Arucious/vesa-speaker-tray/(list of files, cad)

Other CAD files:
vesa_tray_generator_single.scad
