Arucious/vesa-speaker-tray/(commit log)

2026-06-12 Add parametric VESA speaker tray OpenSCAD project
    Scaffold a new, self-contained OpenSCAD project (in vesa-speaker-tray/) that
    implements the VESA speaker tray spec: a parametric monitor-arm tray for
    bookshelf speakers with a lipped floor, rear cutout, ribbed VESA bosses,
    heat-set inserts or through-bolt nut traps, and press-fit TPU pads.
    - Multi-file source: pure-function params, tray()/tpu_pads()/demo_assembly(),
    Part selector entry point (mirrors cable-clamp-generator conventions).
    - BOSL2 for rounded prisms; asserts enforce blind insert pockets, non-overlapping
    bosses, and rear-cutout bounds.
    - pytest + trimesh harness verifies watertightness and the spec's acceptance
    criteria; re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
    [assembly.scad, pads.scad, params.scad, tray.scad, vesa_tray.scad]
2026-06-12 Add parametric VESA mounting-fit validation test
    Intersect the tray with an M4 bolt array on a VESA pattern (tests/fixtures/
    vesa_fit.scad): aligned bolts sit in the hole voids (empty intersection), a
    mismatched pattern collides with boss material. test_vesa_fit.py runs this
    across VESA_PATTERNS (75, 100) in both heat-set and through-bolt modes, with a
    misalignment negative control. Add a plate type via VESA_PATTERNS.
    [vesa_fit.scad]
2026-06-12 Pin toolchain for MakerWorld parity; fix BOSL2 entry-point includes; add CI
    - include BOSL2/std.scad at entry points (vesa_tray.scad, test fixture):
    BOSL2's special-variable defaults resolve through the caller's dynamic
    scope, and OpenSCAD >= 2026 (MakerWorld's renderer) asserts without them
    - pin OpenSCAD 2026.01.14 snapshot + BOSL2 7e5dfe5 in OPENSCAD_SETUP.md
    - add GitHub Actions CI running the pinned toolchain
    [vesa_fit.scad, vesa_tray.scad]
2026-06-13 v2: vertical VESA plate + gusseted cantilever shelf
    v1's tray required the arm head to face fully up; the Secretlab MAGNUS
    tilts up only +70deg, so v1 could never mount. v2 keeps the arm in its
    normal vertical orientation:
    - vertical VESA plate (75/100, M4) below a cantilevered shelf, braced by
    parametric triangular gussets; concave fillet at the junction
    - plate sits entirely below the shelf so the rear-ported cabinet's port
    and I/O stay unobstructed; the cabinet overhangs the rear above the
    arm head (less cantilever moment)
    - fastening: blind Ruthex RX-M4 pockets (5.6mm bore) opening on the rear
    face, dead-ended by front-face bosses; or M4 through-bolts + nut traps
    - retention: fr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
    [assembly.scad, bracket.scad, pads.scad, params.scad, tray.scad, vesa_fit.scad, vesa_tray.scad]
2026-06-13 Add relief counterbore around insert pockets for flush VESA seating
    Heat-set installation squeezes out a small lip of plastic; a 0.4mm-deep,
    +2mm-dia counterbore keeps it below the rear face so the arm's VESA plate
    seats flat.
    [bracket.scad]
2026-06-13 Retention: tall side rails + rear heel by default; full-depth shelf
    Switch default retention to captured-on-all-sides: front lip + 35mm side
    rails + a two-post rear heel with a central cable notch. The rear heel
    needs the shelf to support the full cabinet depth, so shelf_d goes 180->216
    (no rear overhang); cantilever moment rises to ~3.7 N.m, still well within
    the gusset/insert capacity. The old strap-through-slots retention was
    impractical for a 237mm cabinet (slots sat under the speaker; no strap is
    long enough to loop the top) and is now legacy-only.
    - new params: rail_h, rear_heel, rear_heel_h, rear_heel_notch_w
    - square heel posts (rounded posts left a non-manifold sliver where they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
    [assembly.scad, bracket.scad, vesa_tray.scad]
2026-06-13 Extend side rails to the rear edge so they land on the bed
    The rails previously stopped 5mm short of the rear (a workaround for a
    non-manifold junction with the old rounded heel posts). With the heel
    posts now square that workaround is unneeded, and the short rail left its
    rear end floating 5mm above the bed in the print orientation — an overhang
    needing supports. Rails now reach the rear edge; the rear end sits on the
    bed. 18 tests still pass.
    [bracket.scad]
2026-06-13 Retention: unify lip+rails+heel into one seamless wrap-around rim
    Replace the three separate retention pieces (which met with ~1mm tangent
    overlaps that read as slits at the corners) with a single continuous
    rect_tube rim around the cabinet pocket: rounded corners, tall side rails,
    a low front lip, and a rear heel with the central cable notch — all fused.
    Built by extruding the full rim to rail height, then stepping the front and
    rear down and cutting the cable gap. 18 tests pass.
    [bracket.scad]
2026-06-13 Rim: ramp the top-edge transitions (front lip<->rails<->heel) at 45deg
    Replace the abrupt flat height steps with a single ramped top profile cut:
    the front lip rises at 45 deg into the side rails, the rails hold, then fall
    at 45 deg into the rear heel. The whole rim top now flows continuously
    instead of stepping. 18 tests pass.
    [bracket.scad]
2026-06-13 Generator: speaker size as primary toggles, auto-sized shelf, weight-based print hint
    - Reorganize the Customizer for MakerWorld: 'Speaker — START HERE' (width,
    depth, weight) first, then Mounting/Retention, with everything else under
    Advanced groups. Most users only touch width + depth.
    - Shelf auto-sizes to the speaker (shelf_w/shelf_d default 0 = derive); the
    rim, pocket, gussets and pads all follow. Advanced users can still override.
    - Add speaker_weight_kg + recommended_walls/recommended_infill_pct and echo a
    print-setting hint; README gains a 'Print strength' section (table + equation
    + the stress rationale).
    - Default-speaker geometry is unchanged (auto resolves to 160x216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
    [params.scad, vesa_tray.scad]
2026-06-13 Add single-file MakerWorld build (BOSL2 stays an include) + sync tests
    MakerWorld's Parametric Model Maker takes only one .scad file and provides
    BOSL2. Add scripts/build_single_file.py to flatten src/ into
    vesa_tray_generator_single.scad (inlines all local files, keeps only the
    BOSL2 include) and commit that upload artifact. Tests enforce it stays in
    sync with src/ and renders identically (23 tests pass). README documents it.
    [vesa_tray_generator_single.scad]
2026-06-13 CI: publish the MakerWorld single-file as a GitHub Release on version tags
    Add .github/workflows/release.yml: on a vX.Y.Z tag, rebuild and verify the
    flattened single file is in sync, then create a GitHub Release with
    vesa_tray_generator_single.scad attached as the upload artifact.
2026-06-13 docs: document CI, release workflow, and how to cut a tagged release
2026-06-14 docs: add 'Design rationale (the physics)' section
    Consolidate the engineering reasoning behind the bracket: vertical-plate
    kinematics, plate-below-shelf, the cantilever load case (~3.6 N.m, ~0.26 MPa),
    creep-governed sizing, gussets as the structure, the full-depth/rear-heel
    trade-off, capture vs friction retention, print-orientation as engineering,
    walls-over-infill, and fastener choices.
